GALIyes/stm32-csgo-bomb/Core/Inc/main.h

#define LED1_Pin GPIO_PIN_1
#define LED1_GPIO_Port GPIOA
#define LED2_Pin GPIO_PIN_2
#define LED2_GPIO_Port GPIOA
#define LED3_Pin GPIO_PIN_3
#define LED3_GPIO_Port GPIOA
#define KEY2_Pin GPIO_PIN_6
#define KEY2_GPIO_Port GPIOA
#define KEY1_Pin GPIO_PIN_0
#define KEY1_GPIO_Port GPIOB
#define BEEP_Pin GPIO_PIN_10
#define BEEP_GPIO_Port GPIOB
