GALIyes/stm32-csgo-bomb/(commit log)

2026-11-05 feat: STM32F103 版 CS:GO 炸弹模拟器
    - 10 秒倒计时，蜂鸣 / 舵机同节拍加速（gap 每轮 x0.88），TIM4 50 Hz PWM
    - SSD1306 驱动：1024 B 帧缓冲、图形原语、软件 I2C 自动探测地址与线序
    - 概率拆弹：成功率随剩余时间从 80% 递减到 26%，xorshift32 随机源
    - 四种界面与独立音效：待机 / 倒计时 / 拆弹成功 / 失败 / 引爆
    - docs/render_ui.py 可在 PC 上离线渲染界面排版
2026-11-05 docs: 补充 MIT LICENSE 文件
